ChrisChatzibarbas/Arduino-PI-Controlled-Buck-Converter-9V-to-5V-DC-DC/Images/Setup.jpg

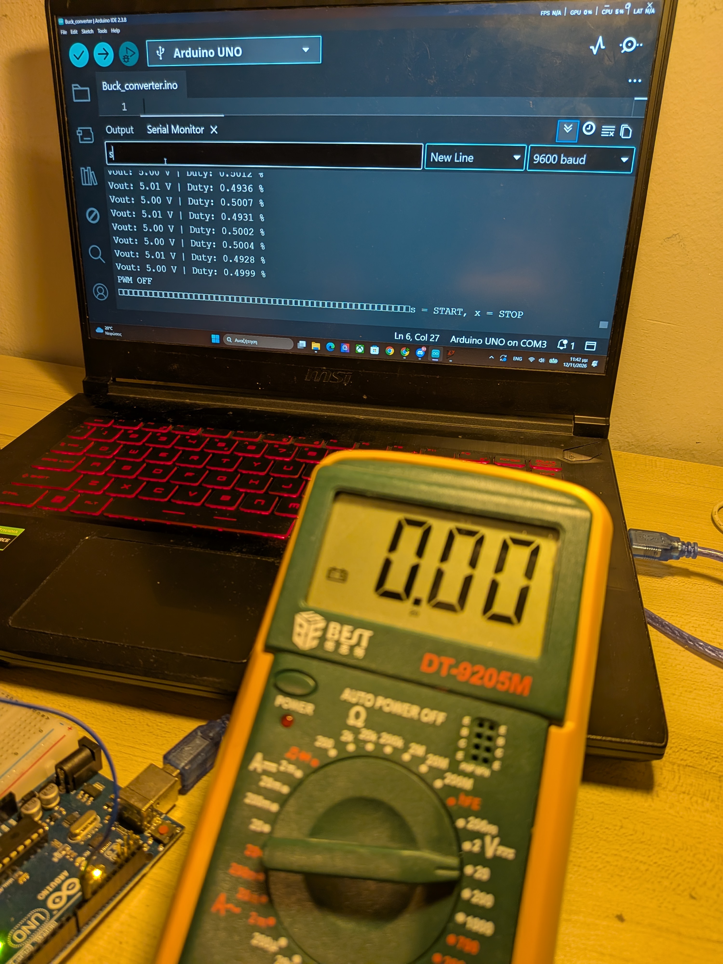
Images/Setup.jpg
