ChrisChatzibarbas/Arduino-PI-Controlled-Buck-Converter-9V-to-5V-DC-DC/Images/Upper_half.jpg

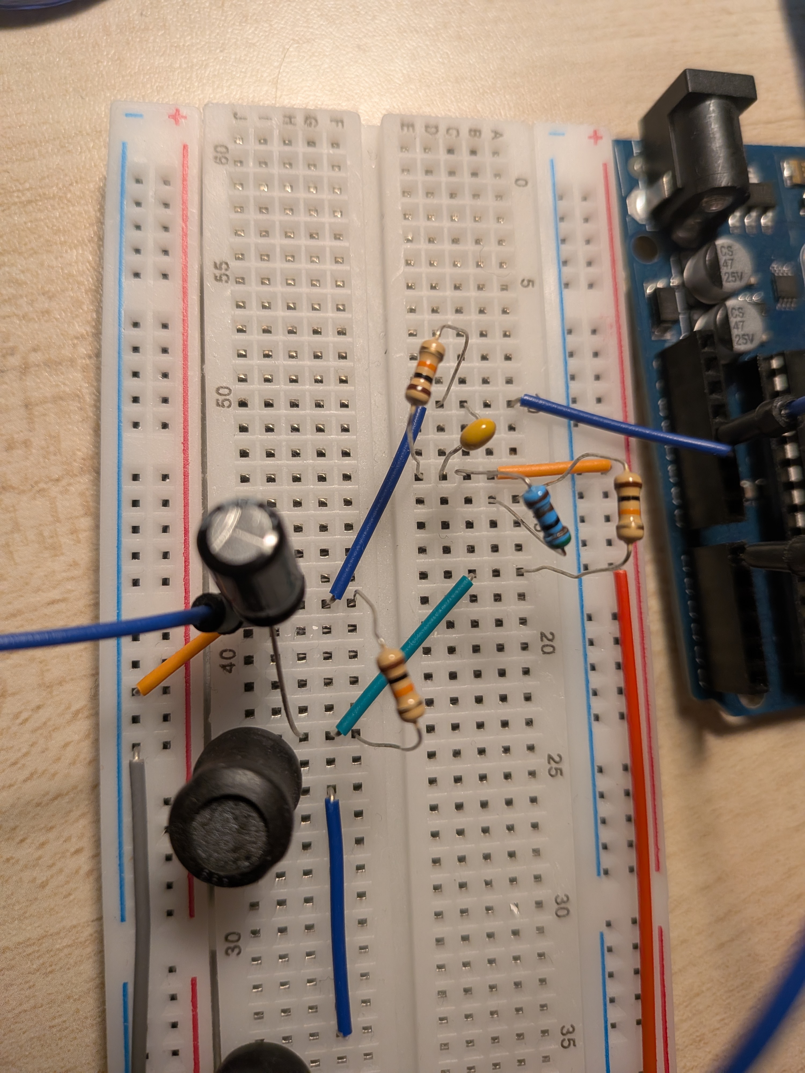
Images/Upper_half.jpg
