ChrisChatzibarbas/Arduino-PI-Controlled-Buck-Converter-9V-to-5V-DC-DC/Images/Lower_half.jpg

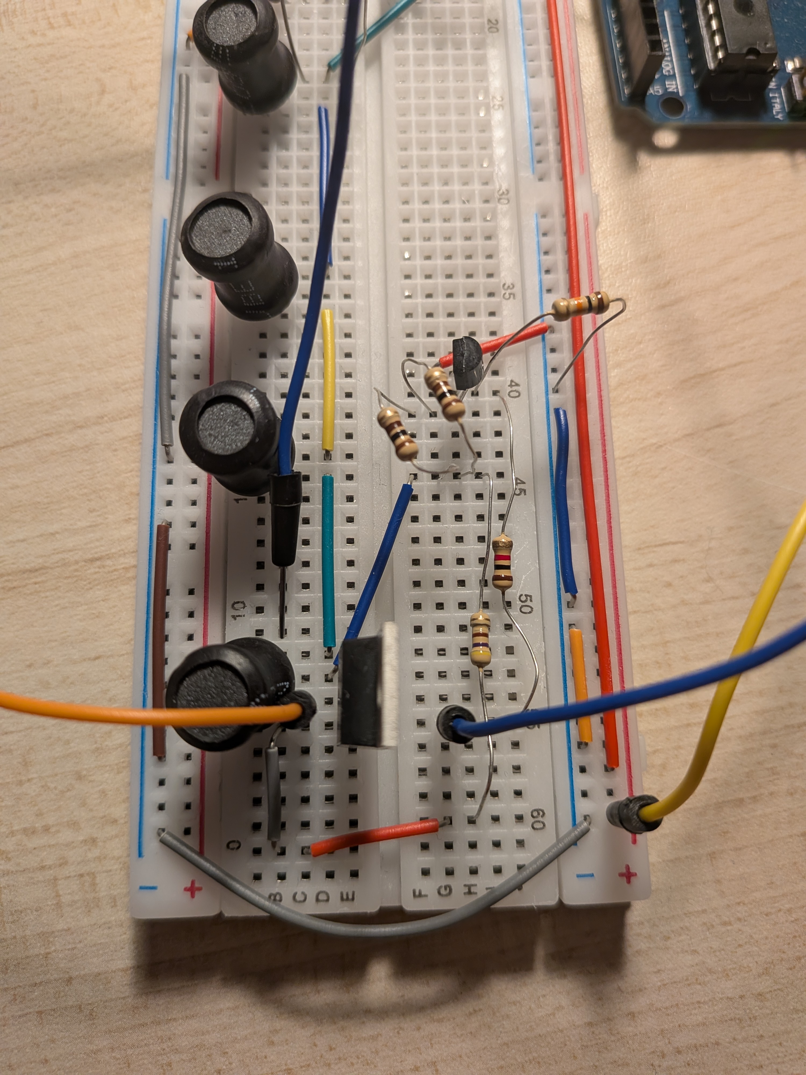
Images/Lower_half.jpg
