ChrisChatzibarbas/Arduino-PI-Controlled-Buck-Converter-9V-to-5V-DC-DC/Images/Whole_circuit.jpg

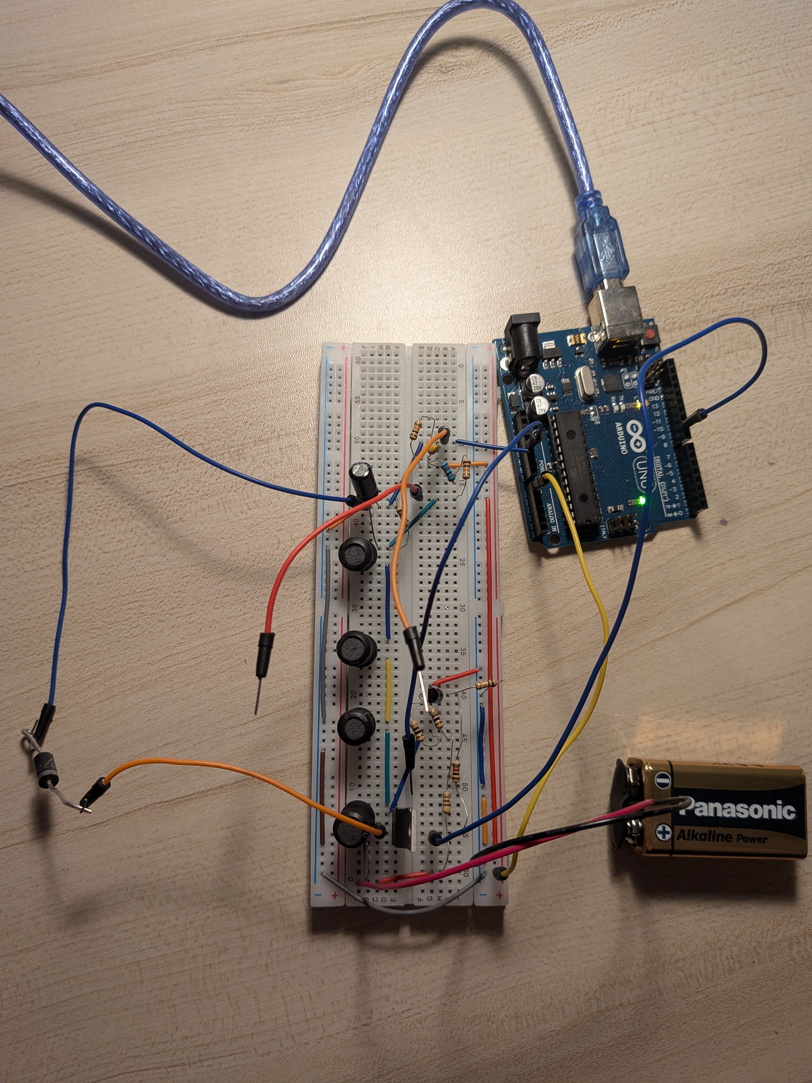
Images/Whole_circuit.jpg
