ChrisChatzibarbas/Arduino-PI-Controlled-Buck-Converter-9V-to-5V-DC-DC/schematic-simulation/Schematic.png

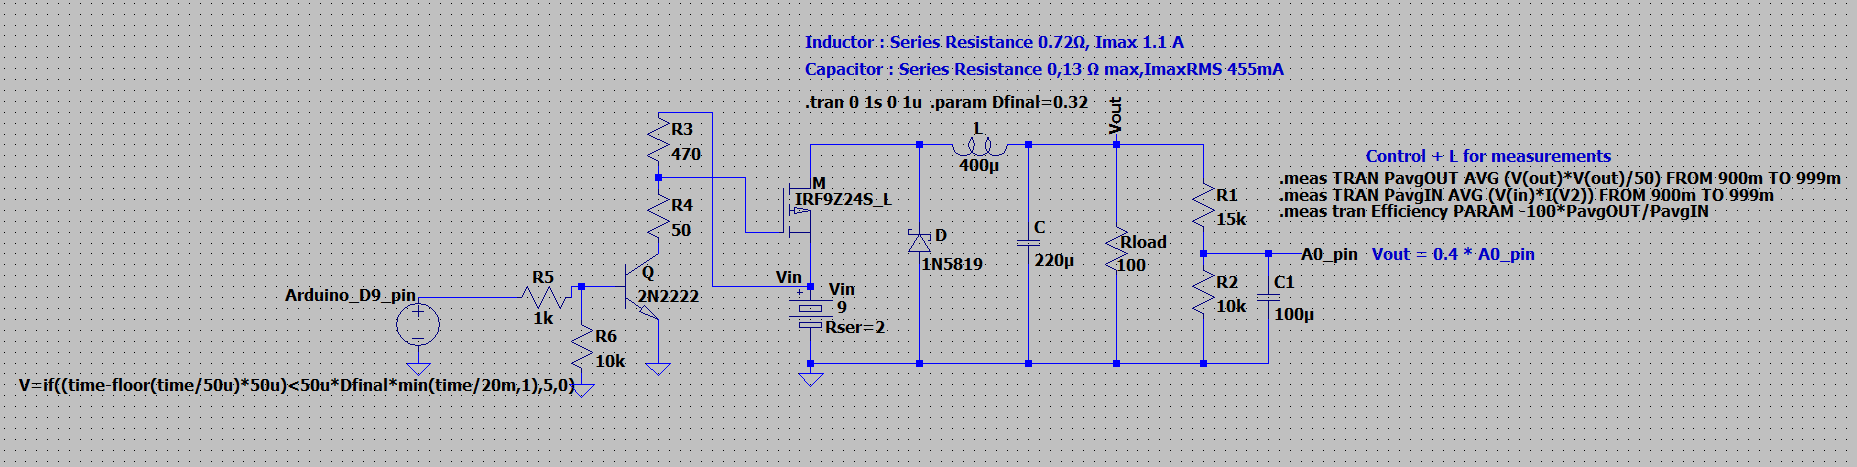
schematic-simulation/Schematic.png
