ChrisChatzibarbas/Arduino-PI-Controlled-Buck-Converter-9V-to-5V-DC-DC/hardware/components.md

# Hardware Components

The following components were used to build the Arduino-controlled DC-DC buck converter.

| Component | Model / Value | Quantity | Purpose |
|---|---|---|---|
| Microcontroller | Arduino Uno | 1 | PWM generation, ADC measurements and PI control |
| P-channel MOSFET | IRF9Z34N | 1 | Main switching element |
| NPN transistor | 2N2222 | 1 | MOSFET gate driver |
| Schottky diode | 1N5822 | 1 | Flyback current path |
| Inductor | 100μH | 4 | Energy storage and current smoothing(4 in series) |
| Electrolytic capacitor | 470 µF, 25 V | 1 | Input voltage filtering |
| Ceramic capacitor | 100 nF | 1 | High-frequency noise filtering |
| Resistor | 15 kΩ | 1 | Upper voltage-divider resistor |
| Resistor | 10 kΩ | 1 | Lower voltage-divider resistor |
| Resistor | 1 kΩ | 1 | Transistor base resistor |
| Resistor | 470 Ω | 1 | MOSFET gate pull-up |
| Resistor | 100 Ω | 2 | MOSFET gate series resistor(2 in parallel) |
| Load resistors | 95 Ω – 10 kΩ | 1 | Experimental load testing |
| DC power source | 9 V Alkaline battery | 1 | Converter input supply |
| Breadboard | Solderless breadboard | 1 | Circuit prototyping |
| Jumper wires | Various lengths | As needed | Electrical connections |
| USB cable | USB connection for Arduino Uno | 1 | Microcontroller power and serial communication |

## Hardware Configuration

The power stage uses a P-channel MOSFET driven through a 2N2222 transistor. The MOSFET is controlled by a 20 kHz PWM signal generated by the Arduino Uno.

A Schottky diode, inductor and output capacitor form the buck converter power stage.

Output voltage is measured through a 15 kΩ / 10 kΩ resistor divider connected to analog input A0.

The Arduino implements closed-loop PI voltage regulation, duty-cycle limiting and software overvoltage detection.

## Hardware Considerations

During experimental testing, switching-related interference affected ADC voltage measurements.

Improving the grounding arrangement eliminated the observed measurement spikes in the diagnostic test.

This highlighted the importance of proper grounding, wiring layout and noise management in switching power converters.
