ChrisChatzibarbas/Arduino-PI-Controlled-Buck-Converter-9V-to-5V-DC-DC/schematic-simulation/Results for 95Ω.png

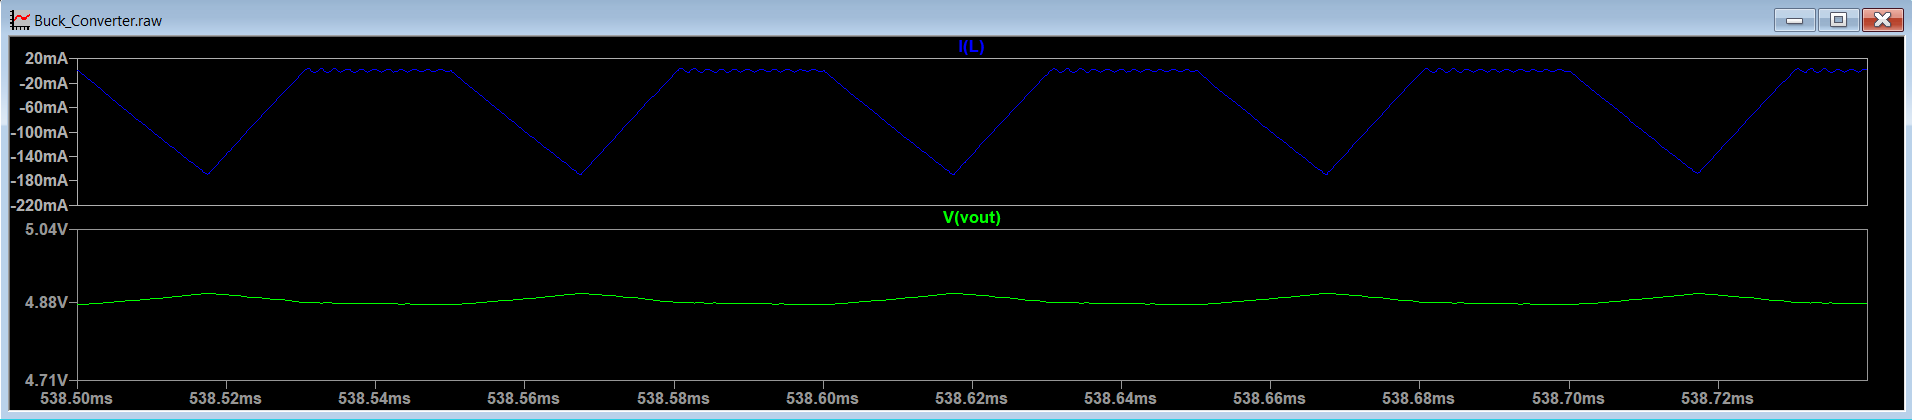
schematic-simulation/Results for 95Ω.png
